lishuo4096/PY32F071-ADI-USBi/hardware/SCH_alternative_usbi_v1.0_2026-10-12.pdf

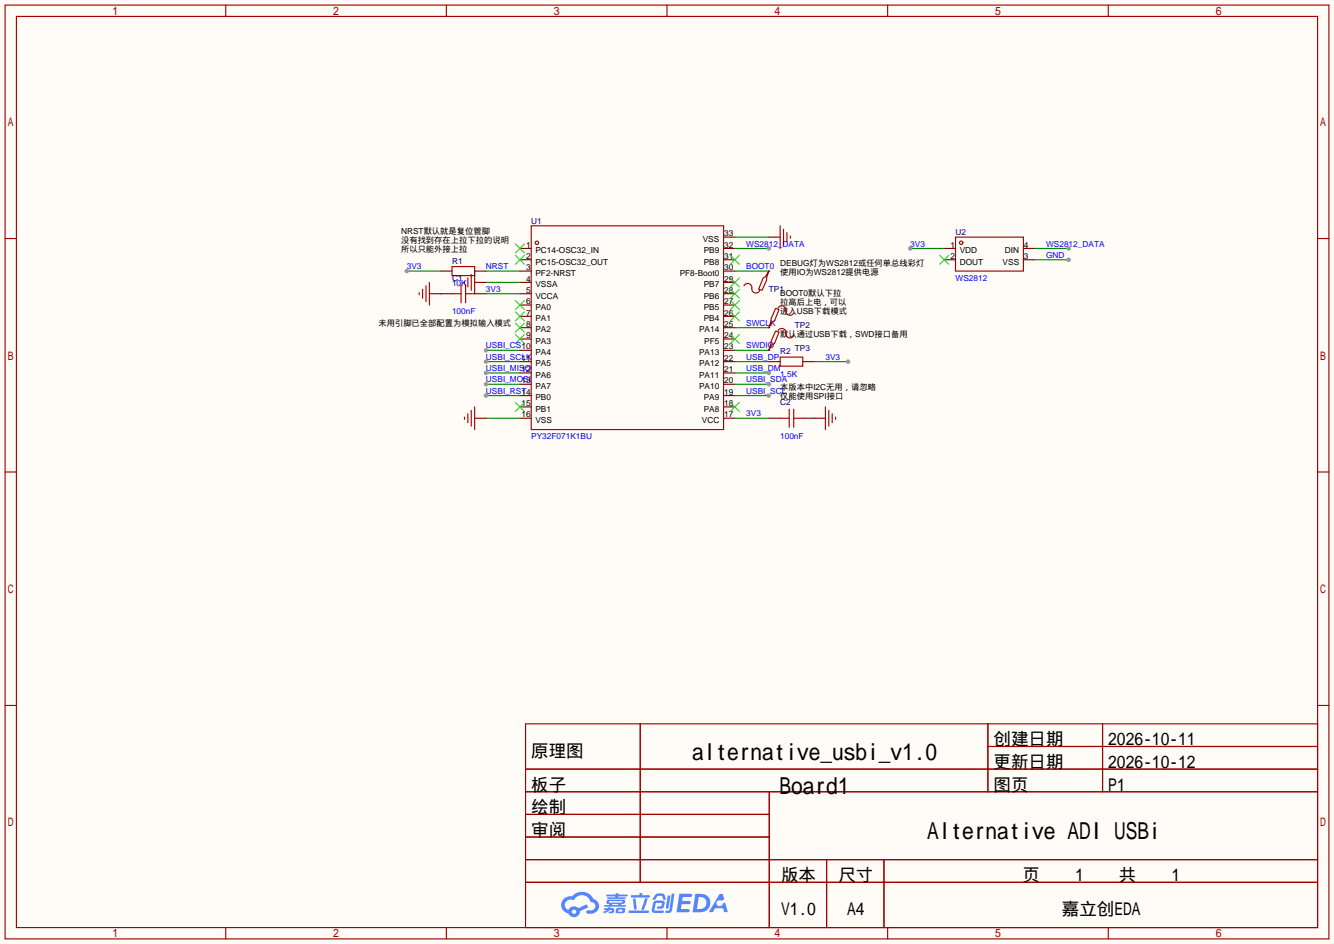
[picture p3: page 1]

原理图 | alternative_usbi_v1.0 | 创建日期 | 2026-10-11

更新日期 | 2026-10-12

板子 | Board1 | 图页 | P1
绘制 | | Alternative ADI USBi
审阅

V1.0 | A4 | 嘉立创EDA
