lishuo4096/PY32F071-ADI-USBi/firmware/Core/SRC/main.c

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

/* Includes ------------------------------------------------------------------*/
#include "main.h"
#include "rcc.h"
#include "gpio.h"
#include "dma.h"
#include "tim.h"
#include "usb.h"
#include "usb_config.h"
#include "spi.h"
#include "i2c.h"
#include "iwdg.h"
/* USER CODE BEGIN Includes */
#include "usbi.h"
#include "usbi_led.h"
/* USER CODE END Includes */

/* External functions --------------------------------------------------------*/
/**
  * @brief  The application entry point.
  * @retval int
  */
int main(void)
{
  /* MCU Configuration--------------------------------------------------------*/

  /* Reset of all peripherals, Initializes the Flash interface and the Systick. */
  HAL_Init();
  /* USER CODE BEGIN Init */
  HAL_Delay(20);//等待上电稳定

  /* USER CODE END Init */

  /* Configure the system clock */
  Studio_RCC_Init();
  /* Initialize all configured peripherals */
  Studio_GPIO_Init();
  Studio_DMA_Init();
  Studio_TIM14_Init();
  Studio_USB_Init();
  Studio_SPI1_Init();
  Studio_I2C1_Init();
  Studio_IWDG_Init();
  Studio_TIM17_Init();
  /* USER CODE BEGIN 2 */

  /* USBi 总线侧初始化（片选、SPI 模式、释放目标 DSP 的 RESET）。
   * 必须在 Studio_SPI1_Init() / Studio_I2C1_Init() 之后。 */
  usbi_init();

  /* WS2812 状态指示灯初始化（供电、DMA、20 ms 呼吸节拍） */
  usbi_led_init();

  /* USER CODE END 2 */

  /* Infinite loop */
  /* USER CODE BEGIN WHILE */
  while(1)
  {
    
    /* 烧录结束后的自动复位（需要毫秒级延时，不能在 USB 中断里做） */
    usbi_task();
    /* WS2812 状态指示灯：呼吸/闪烁状态机，20 ms 一个节拍 */
    usbi_led_task();

    HAL_IWDG_Refresh(&hiwdg);//喂狗
    /* USER CODE END WHILE */
    /* USER CODE BEGIN 3 */
  }
  /* USER CODE END 3 */
}

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
