lishuo4096/PY32F071-ADI-USBi/(commit log)

2026-10-12 V1.0: PY32F071K1BU6 虚拟 USBi 固件（SPI 模式）
    - USB 全速设备，单接口 class 0xFF / 零端点，VID 0x0456 PID 0x7031
    - EP0 vendor 请求 0xB2 WriteRegister / 0xB3 ReadRegister / 0xB4 ReadRegisterResponse / 0xB5 / 0xB6
    - wLength > 4096 的块写走 CherryUSB EP0 流式接收（分块 256B 转发到 SPI）
    - 总线：V1.0 只用 SPI（I2C 后端已在 usbi.c 中 #if 0 归档，I2C1 初始化保留）
    - RESET(PB0) 常态推挽输出高；WS2812 指示灯按总线/读写/烧录分色
    - 编译：70 源文件 0 失败，text 19032 / data 4216 / bss 3336
2026-10-12 docs: 增加中英双语 README（项目理念/硬件/引脚/LED 状态/I2C 未实现说明）
2026-10-12 docs+release: 驱动安装/DFU 烧录教程，预编译 hex/bin，更新硬件原理图
    - README 新增「安装驱动（Windows）」「烧录固件（PY32 DFU）」「预编译固件」三节（中英双语）
    - firmware/prebuilt/ 加入 V1.0 的 Alternative_ADI_USBI.hex / .bin
    - hardware/ 更新：补去耦电容、D+ 增加 1.5 kΩ 上拉
2026-10-12 docs: README 加入 PY32 DfuTool 烧录界面截图（中英双语）
2026-10-21 v1.2.0：三种 LED 显示模式、WS2812 峰值闪杂色修复、I²C 后端可用
    LED（firmware/Core/SRC/ws2812.c、usbi_led.c、INC/usbi_led.h）
    - 显示模式改成编译期三选一 USBI_LED_MODE=1/2/3：
    1 经典（未枚举白呼吸 / 枚举后模式色呼吸 / 烧录闪）
    2 插入才亮（未枚举全灭）
    3 只有活动才亮（默认；枚举后呼吸 3 s 即灭，之后只有读写与烧录才亮）
    非 1/2/3 的值由 #error 拦住。
    - 烧录期间任何一条读/写命令都留可见响应：写把相位拉回"亮"，读打一个凹口
    （永远落在当前状态的反面），间隙由 40/40 ms 方波接管。
    - 修「绿色呼吸到峰值偶尔闪橙色」：帧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
2026-10-21 docs: 预编译固件一节补 Releases 下载入口（中英双语）
