lishuo4096/PY32F071-ADI-USBi/(notices)

Notices in the files:
firmware/Core/SRC/main.c:
© Copyright (c) 2026 Puya Semiconductor Co.
All rights reserved.
This software component is licensed by Mcu Studio under BSD 3-Clause license,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
